jakeson21/8-Band-EQ/2-Band-EQ-Board/2-Band-EQ-Board.png

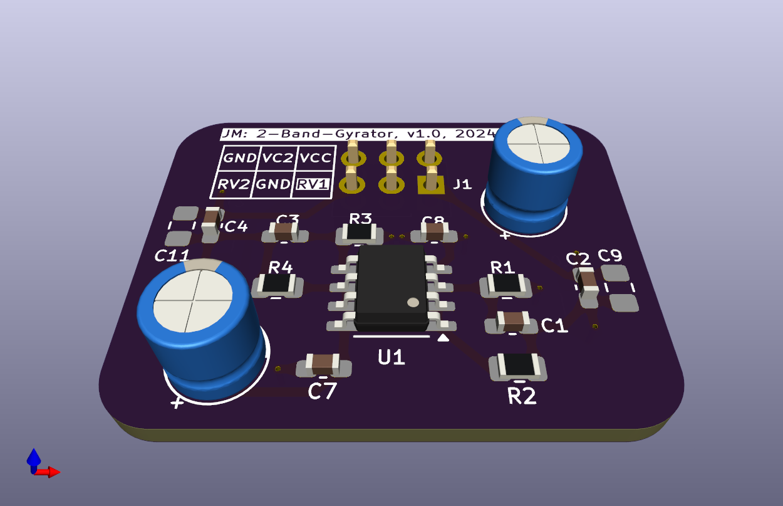
2-Band-EQ-Board/2-Band-EQ-Board.png
