jakeson21/8-Band-EQ/3d-models/RD901F-40-15R1.png

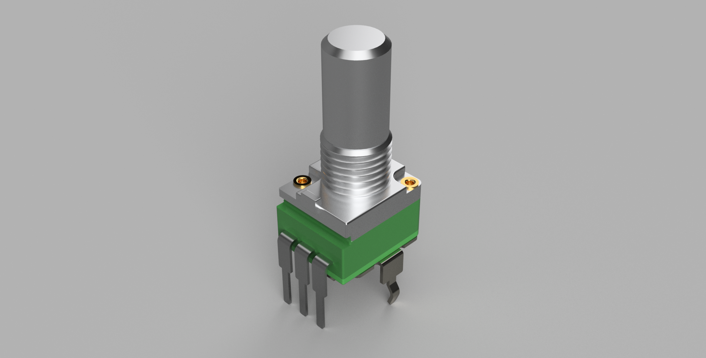
3d-models/RD901F-40-15R1.png
