jakeson21/8-Band-EQ/3d-models/RV16AF-41.png

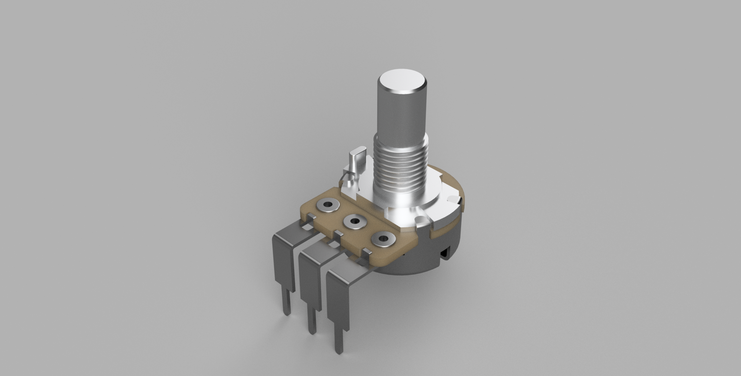
3d-models/RV16AF-41.png
