jakeson21/8-Band-EQ/Combined-BOM.xlsx

Sheet: Main-Board-BOM
Reference | Value | Datasheet | Footprint | Qty | DNP
C1,C17 | 10u | https://www.digikey.com/en/products/detail/w%C3%BCrth-elektronik/865080440002/5728025 | Capacitor_SMD:CP_Elec_4x5.4 | 2
C2 | 0.22u | https://www.digikey.com/en/products/detail/murata-electronics/GCM188R71E224KA55D/1765183 | Capacitor_SMD:C_0603_1608Metric_Pad1.08x0.95mm_HandSolder | 1
C3 | 270p | https://www.digikey.com/en/products/detail/yageo/CC0603KRX7R9BB271/372858 | Capacitor_SMD:C_0603_1608Metric_Pad1.08x0.95mm_HandSolder | 1
C4,C5,C18,C20,C21 | 100u | https://www.digikey.com/en/products/detail/kemet/ESK107M016AC3AA/3083016 | Capacitor_THT:CP_Radial_D5.0mm_P2.00mm | 5
C6,C7,C22,C23 | 0.1u | https://www.digikey.com/en/products/detail/yageo/CC0603KRX7R8BB104/2103079 | Capacitor_SMD:C_0603_1608Metric_Pad1.08x0.95mm_HandSolder | 4
C8,C9 | 1u | https://www.digikey.com/en/products/detail/kemet/C0603C105K4RACTU/2199788 | Capacitor_SMD:C_0603_1608Metric_Pad1.08x0.95mm_HandSolder | 2
C10 | 1n | https://www.digikey.com/en/products/detail/kemet/C0603C102K4RACTU/2199721 | Capacitor_SMD:C_0805_2012Metric | 1
C11,C16 | 22n | https://www.digikey.com/en/products/detail/kemet/C0603C223K4RAC7867/411092 | Capacitor_SMD:C_0805_2012Metric | 2
C12,C15 | 470p | https://www.digikey.com/en/products/detail/kemet/C0603C471K3RAC7867/2200814 | Capacitor_SMD:C_0805_2012Metric | 2
C13,C14 | 220p | https://www.digikey.com/en/products/detail/kemet/C0603C221K3RAC7867/2200227 | Capacitor_SMD:C_0805_2012Metric | 2
C19 | 47u | https://www.digikey.com/en/products/detail/w%C3%BCrth-elektronik/860020372004/5727028 | Capacitor_THT:CP_Radial_D5.0mm_P2.00mm | 1
C24 | 100u | https://www.digikey.com/en/products/detail/kemet/T491D107K016AT/818630 | Capacitor_Tantalum_SMD:CP_EIA-7343-31_Kemet-D_Pad2.25x2.55mm_HandSolder | 1 | DNP
D1,D2 | 1N914 | http://www.vishay.com/docs/85622/1n914.pdf | Diode_THT:D_DO-35_SOD27_P2.54mm_Vertical_AnodeUp | 2
D3 | 5.6V ZENER EDZVT2R5.6B | https://www.rohm.com/datasheet?p=EDZV5.6B&dist=Digi-key&media=referral&campaign=Digi-key | Diode_SMD:D_SOD-523 | 1
D4 | 1.5-2V | ~ | LED_THT:LED_D3.0mm_Clear | 1
D5 | 1N4001 | http://www.vishay.com/docs/88503/1n4001.pdf | Diode_THT:D_DO-41_SOD81_P7.62mm_Horizontal | 1
J1,J8 | B3B-XH-A | https://www.digikey.com/en/products/detail/jst-sales-america-inc/b3b-xh-a/1651046 | Connector_JST:JST_XH_B3B-XH-A_1x03_P2.50mm_Vertical | 2
J2,J3 | A-6730 | https://www.taydaelectronics.com/datasheets/files/A-6728.pdf | Project_Library:Jack_6.35mm_Neutrik_NMJ4HFD2_Horizontal | 2
J4 | A-4118 | http://www.taydaelectronics.com/datasheets/files/A-4118.pdf | Connector_BarrelJack:BarrelJack_Horizontal | 1
J5 | Gain | ~ | Connector_PinHeader_2.54mm:PinHeader_1x03_P2.54mm_Vertical | 1
POT1 | A-4728 | https://www.taydaelectronics.com/potentiometer-variable-resistors/rotary-potentiometer/linear/10k-ohm-linear-taper-potentiometer-knurled-plastic-round-shaft-p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 | Project_Library:Potentiometer_Alpha_RD901F-40-00D_Single_Vertical_CircularHoles | 1
Q1,Q3 | MMBF4393LT1G | https://www.digikey.com/en/products/detail/onsemi/MMBF4393LT1G/919583 | Package_TO_SOT_SMD:SOT-23-3 | 2
Q2,Q4 | 2N4401D75ZCT-ND | https://www.digikey.com/en/products/detail/onsemi/2n4401tar/458821 | Package_TO_SOT_THT:TO-92_Inline_Wide | 2
R1,R4,R5,R8 | 10K | ~ | Resistor_SMD:R_0805_2012Metric | 4
R2,R24 | 2.2K | ~ | Resistor_SMD:R_0805_2012Metric | 2
R3 | 470K | ~ | Resistor_SMD:R_0805_2012Metric | 1
R6,R7 | 3.3K | ~ | Resistor_SMD:R_0805_2012Metric | 2
R9,R11,R12,R13,R17,R21,R23 | 1M | ~ | Resistor_SMD:R_0805_2012Metric | 7
R10 | 100 | ~ | Resistor_SMD:R_0805_2012Metric | 1
R14,R15,R16,R18,R19,R20 | 56K | ~ | Resistor_SMD:R_0805_2012Metric | 6
R22 | 4.7K | ~ | Resistor_SMD:R_0805_2012Metric | 1
SW1 | SW_Push | ~ | Connector_Molex:Molex_KK-254_AE-6410-02A_1x02_P2.54mm_Vertical | 1
U1,U2 | TL072 | http://www.ti.com/lit/ds/symlink/tl071.pdf | Package_SO:SOIC-8_3.9x4.9mm_P1.27mm | 2

Sheet: 4-Row-POT-BOM
Reference | Value | Datasheet | Footprint | Qty | DNP
J1,J2 | FHMD-DA006G1NBON-B | 4324-FHMD-DA006G1NBON-B-ND | Connector_PinSocket_2.54mm:PinSocket_2x03_P2.54mm_Vertical | 2
J3,J4,J5,J6 | S3B-XH-A | 455-S3B-XH-A-ND | Connector_JST:JST_XH_S3B-XH-A_1x03_P2.50mm_Horizontal | 4
RV1,RV2,RV3,RV4 | 10K | https://www.taydaelectronics.com/potentiometer-variable-resistors/rotary-potentiometer/linear/10k-ohm-linear-taper-potentiometer-knurled-plastic-round-shaft-p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 | Project_Library:Potentiometer_Alpha_RD901F-40-00D_Single_Vertical_CircularHoles | 4

Sheet: 2-Band-BOM
Reference | Value | Datasheet | Footprint | Qty | DNP
C1 | 33n |  | Capacitor_SMD:C_0603_1608Metric_Pad1.08x0.95mm_HandSolder | 1
C2 | 0.68u |  | Capacitor_SMD:C_0603_1608Metric_Pad1.08x0.95mm_HandSolder | 1
C3 | 15n |  | Capacitor_SMD:C_0603_1608Metric_Pad1.08x0.95mm_HandSolder | 1
C4 | 0.33u |  | Capacitor_SMD:C_0603_1608Metric_Pad1.08x0.95mm_HandSolder | 1
C5,C6 | 100u | https://www.digikey.com/en/products/detail/kemet/ESK107M016AC3AA/3083016 | Capacitor_THT:CP_Radial_D5.0mm_P2.00mm | 2
C7,C8 | 0.1u | https://www.digikey.com/en/products/detail/yageo/CC0603KRX7R8BB104/2103079 | Capacitor_SMD:C_0603_1608Metric_Pad1.08x0.95mm_HandSolder | 2
C9,C11 | 1.5u |  | Capacitor_SMD:C_0805_2012Metric_Pad1.18x1.45mm_HandSolder | 2 | DNP
C10,C12 | 3.3u |  | Capacitor_SMD:C_1206_3216Metric_Pad1.33x1.80mm_HandSolder | 2 | DNP
J1 | PHED-DS006G1ABOGA-A006 | https://www.digikey.com/en/products/detail/superior-tech/PHED-DS006G1ABOGA-A006/16583466 | Connector_PinHeader_2.54mm:PinHeader_2x03_P2.54mm_Vertical | 1
R1,R3 | 100K | ~ | Resistor_SMD:R_0805_2012Metric | 2
R2,R4 | 330 | ~ | Resistor_SMD:R_0805_2012Metric | 2
U1 | 296-TL072HIDRCT-ND | http://www.ti.com/lit/ds/symlink/tl071.pdf | Package_SO:SOIC-8_3.9x4.9mm_P1.27mm | 1

Sheet: Sheet1
On Hand | Order | Reference | Value | Datasheet | Footprint | Qty | DNP
 | 10 | C1 | 33n | https://www.digikey.com/en/products/detail/yageo/CC0603JRX7R9BB333/5883689 | Capacitor_SMD:C_0603_1608Metric_Pad1.08x0.95mm_HandSolder | 1
 | 10 | C1,C17 | 10u | https://www.digikey.com/en/products/detail/w%C3%BCrth-elektronik/865080440002/5728025 | Capacitor_SMD:CP_Elec_4x5.4 | 2
 | 10 | C10 | 1n | https://www.digikey.com/en/products/detail/kemet/C0603C102K4RACTU/2199721 | Capacitor_SMD:C_0805_2012Metric | 1
 | 10 | C10,C12 | 3.3u | https://www.digikey.com/en/products/detail/samsung-electro-mechanics/CL31B335KAHVPNE/5961344 | Capacitor_SMD:C_1206_3216Metric_Pad1.33x1.80mm_HandSolder | 2 | DNP
 | 10 | C11,C16 | 22n | https://www.digikey.com/en/products/detail/kemet/C0603C223K4RAC7867/411092 | Capacitor_SMD:C_0805_2012Metric | 2
 | 10 | C12,C15 | 470p | https://www.digikey.com/en/products/detail/kemet/C0603C471K3RAC7867/2200814 | Capacitor_SMD:C_0805_2012Metric | 2
 | 10 | C13,C14 | 220p | https://www.digikey.com/en/products/detail/kemet/C0603C221K3RAC7867/2200227 | Capacitor_SMD:C_0805_2012Metric | 2
8 | 0 | C19 | 47u | https://www.digikey.com/en/products/detail/w%C3%BCrth-elektronik/860020372004/5727028 | Capacitor_THT:CP_Radial_D5.0mm_P2.00mm | 1
 | 10 | C2 | 0.22u | https://www.digikey.com/en/products/detail/murata-electronics/GCM188R71E224KA55D/1765183 | Capacitor_SMD:C_0603_1608Metric_Pad1.08x0.95mm_HandSolder | 1
 | 10 | C2 | 0.68u | https://www.digikey.com/en/products/detail/yageo/CC0603KRX7R8BB684/16797741 | Capacitor_SMD:C_0603_1608Metric_Pad1.08x0.95mm_HandSolder | 1
0 | 0 | C24 | 100u | https://www.digikey.com/en/products/detail/kemet/T491D107K016AT/818630 | Capacitor_Tantalum_SMD:CP_EIA-7343-31_Kemet-D_Pad2.25x2.55mm_HandSolder | 1 | DNP
 | 10 | C3 | 270p | https://www.digikey.com/en/products/detail/yageo/CC0603KRX7R9BB271/372858 | Capacitor_SMD:C_0603_1608Metric_Pad1.08x0.95mm_HandSolder | 1
 | 10 | C3 | 15n | https://www.digikey.com/en/products/detail/yageo/CC0603JRX7R9BB153/5883678 | Capacitor_SMD:C_0603_1608Metric_Pad1.08x0.95mm_HandSolder | 1
 | 10 | C4 | 330n | https://www.digikey.com/en/products/detail/samsung-electro-mechanics/CL31B335KAHVPNE/5961344 | Capacitor_SMD:C_0603_1608Metric_Pad1.08x0.95mm_HandSolder | 1
8 | 10 | C4,C5,C18,C20,C21 | 100u | https://www.digikey.com/en/products/detail/kemet/ESK107M016AC3AA/3083016 | Capacitor_THT:CP_Radial_D5.0mm_P2.00mm | 5
 | 0 | C5,C6 | 100u | https://www.digikey.com/en/products/detail/kemet/ESK107M016AC3AA/3083016 | Capacitor_THT:CP_Radial_D5.0mm_P2.00mm | 2
 | 20 | C6,C7,C22,C23 | 0.1u | https://www.digikey.com/en/products/detail/yageo/CC0603KRX7R8BB104/2103079 | Capacitor_SMD:C_0603_1608Metric_Pad1.08x0.95mm_HandSolder | 4
 | 0 | C7,C8 | 0.1u | https://www.digikey.com/en/products/detail/yageo/CC0603KRX7R8BB104/2103079 | Capacitor_SMD:C_0603_1608Metric_Pad1.08x0.95mm_HandSolder | 2
 | 20 | C8,C9 | 1u | https://www.digikey.com/en/products/detail/kemet/C0603C105K4RACTU/2199788 | Capacitor_SMD:C_0603_1608Metric_Pad1.08x0.95mm_HandSolder | 2
 | 10 | C9,C11 | 1.5u | https://www.digikey.com/en/products/detail/tdk-corporation/CGA4J3X7R1E155K125AB/3949992 | Capacitor_SMD:C_0805_2012Metric_Pad1.18x1.45mm_HandSolder | 2 | DNP
 | 10 | D1,D2 | 1N914 | https://www.digikey.com/en/products/detail/onsemi/1N914/978749 | Diode_THT:D_DO-35_SOD27_P2.54mm_Vertical_AnodeUp | 2
 | 10 | D3 | 5.6V ZENER EDZVT2R5.6B | https://www.rohm.com/datasheet?p=EDZV5.6B&dist=Digi-key&media=referral&campaign=Digi-key | Diode_SMD:D_SOD-523 | 1
10 | 0 | D4 | 1.5-2V | ~ | LED_THT:LED_D3.0mm_Clear | 1
10 | 0 | D5 | 1N4001 | http://www.vishay.com/docs/88503/1n4001.pdf | Diode_THT:D_DO-41_SOD81_P7.62mm_Horizontal | 1
 | 10 | J1 | PHED-DS006G1ABOGA-A006 | https://www.digikey.com/en/products/detail/superior-tech/PHED-DS006G1ABOGA-A006/16583466 | Connector_PinHeader_2.54mm:PinHeader_2x03_P2.54mm_Vertical | 1
 | 10 | J1,J2 | FHMD-DA006G1NBON-B | 4324-FHMD-DA006G1NBON-B-ND | Connector_PinSocket_2.54mm:PinSocket_2x03_P2.54mm_Vertical | 2
 | 10 | J1,J8 | B3B-XH-A | https://www.digikey.com/en/products/detail/jst-sales-america-inc/b3b-xh-a/1651046 | Connector_JST:JST_XH_B3B-XH-A_1x03_P2.50mm_Vertical | 2
NEED 4 | 0 | J2,J3 | A-6730 | https://www.taydaelectronics.com/datasheets/files/A-6728.pdf | Project_Library:Jack_6.35mm_Neutrik_NMJ4HFD2_Horizontal | 2
 | 10 | J3,J4,J5,J6 | S3B-XH-A | 455-S3B-XH-A-ND | Connector_JST:JST_XH_S3B-XH-A_1x03_P2.50mm_Horizontal | 4
1 | 0 | J4 | A-4118 | http://www.taydaelectronics.com/datasheets/files/A-4118.pdf | Connector_BarrelJack:BarrelJack_Horizontal | 1
100 | 0 | J5 | Gain | ~ | Connector_PinHeader_2.54mm:PinHeader_1x03_P2.54mm_Vertical | 1
NEED 10+ | 0 | POT1 | A-4728 | https://www.taydaelectronics.com/potentiometer-variable-resistors/rotary-potentiometer/linear/10k-ohm-linear-taper-potentiometer-knurled-plastic-round-shaft-p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 | Project_Library:Potentiometer_Alpha_RD901F-40-00D_Single_Vertical_CircularHoles | 1
 | 10 | Q1,Q3 | MMBF4393LT1G | https://www.digikey.com/en/products/detail/onsemi/MMBF4393LT1G/919583 | Package_TO_SOT_SMD:SOT-23-3 | 2
20 | 0 | Q2,Q4 | 2N4401D75ZCT-ND | https://www.digikey.com/en/products/detail/onsemi/2n4401tar/458821 | Package_TO_SOT_THT:TO-92_Inline_Wide | 2
50 | 0 | R1,R3 | 100K | ~ | Resistor_SMD:R_0805_2012Metric | 2
50 | 0 | R1,R4,R5,R8 | 10K | ~ | Resistor_SMD:R_0805_2012Metric | 4
50 | 0 | R10 | 100 | ~ | Resistor_SMD:R_0805_2012Metric | 1
50 | 0 | R14,R15,R16,R18,R19,R20 | 56K | ~ | Resistor_SMD:R_0805_2012Metric | 6
50 | 0 | R2,R24 | 2.2K | ~ | Resistor_SMD:R_0805_2012Metric | 2
50 | 0 | R2,R4 | 330 | ~ | Resistor_SMD:R_0805_2012Metric | 2
50 | 0 | R22 | 4.7K | ~ | Resistor_SMD:R_0805_2012Metric | 1
50 | 0 | R3 | 470K | ~ | Resistor_SMD:R_0805_2012Metric | 1
50 | 0 | R6,R7 | 3.3K | ~ | Resistor_SMD:R_0805_2012Metric | 2
50 | 0 | R9,R11,R12,R13,R17,R21,R23 | 1M | ~ | Resistor_SMD:R_0805_2012Metric | 7
NEED above | 0 | RV1,RV2,RV3,RV4 | 10K | https://www.taydaelectronics.com/potentiometer-variable-resistors/rotary-potentiometer/linear/10k-ohm-linear-taper-potentiometer-knurled-plastic-round-shaft-p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 | Project_Library:Potentiometer_Alpha_RD901F-40-00D_Single_Vertical_CircularHoles | 4
4 | 0 | SW1 | SW_Push | ~ | Connector_Molex:Molex_KK-254_AE-6410-02A_1x02_P2.54mm_Vertical | 1
 | 0 | U1 | 296-TL072HIDRCT-ND | http://www.ti.com/lit/ds/symlink/tl071.pdf | Package_SO:SOIC-8_3.9x4.9mm_P1.27mm | 1
 | 20 | U1,U2 | 296-TL072HIDRCT-ND | http://www.ti.com/lit/ds/symlink/tl071.pdf | Package_SO:SOIC-8_3.9x4.9mm_P1.27mm | 2
 | 11.74
 | 0.7
 | 2.43
 | $14.87
