jakeson21/8-Band-EQ/Cap_options.xlsx

Sheet: Options
C | URL | Spacing | Size | Description
1.5u | https://www.digikey.com/en/products/detail/kemet/R82DC4150AA60J/2704685 | 0.197" (5.00mm) | 0.283" L x 0.236" W (7.20mm x 6.00mm) | CAP FILM 1.5UF 5% 63VDC RADIAL | $0.81 | $0.70 | https://www.taydaelectronics.com/capacitors/polyester-film-box-type-capacitors/1-5uf-1500nf-63v-5-polyester-film-box-type-capacitor.html
3.3u | https://www.digikey.com/en/products/detail/kemet/R60DF4330AA6AK/6124494 | 0.394" (10.00mm) | 0.512" L x 0.236" W (13.00mm x 6.00mm) | CAP FILM 3.3UF 10% 63VDC RADIAL | $1.28
0.33u | https://www.digikey.com/en/products/detail/murata-electronics/GRM31C5C1E334JE01L/16033803 |  | 1206 (3216 Metric) | CAP CER 0.33UF 25V C0G/NP0 1206

Sheet: Sheet1
Relative Permittivity of Common Dielectric Materials
Material | εr(k)
Vacuum | 1 |  | Size | Cost | Min C | Max C | εr(k) | C vs. T | ESR | Service Life | DC Bias | Acoustic Noise
Polyethylene sulfide | 3 | MLCC | 1 | 1 |  |  | 5 | 5 | 5
Polyethylene terephthalate | 3.3
Polypropylene | 2.2
Impregnated paper | 2 to 6
Mylar | 3.1
Mica | 6.8
Aluminum oxide | 8.5
Tantalum pentoxide | 27.7
Paraelectric ceramics (Class I) | 5 to 90
Strontium titanate | 310
Barium titanate (Class II) | 3000 to 8000
