jakeson21/8-Band-EQ/3d-models/NMJ4HFD2.STEP

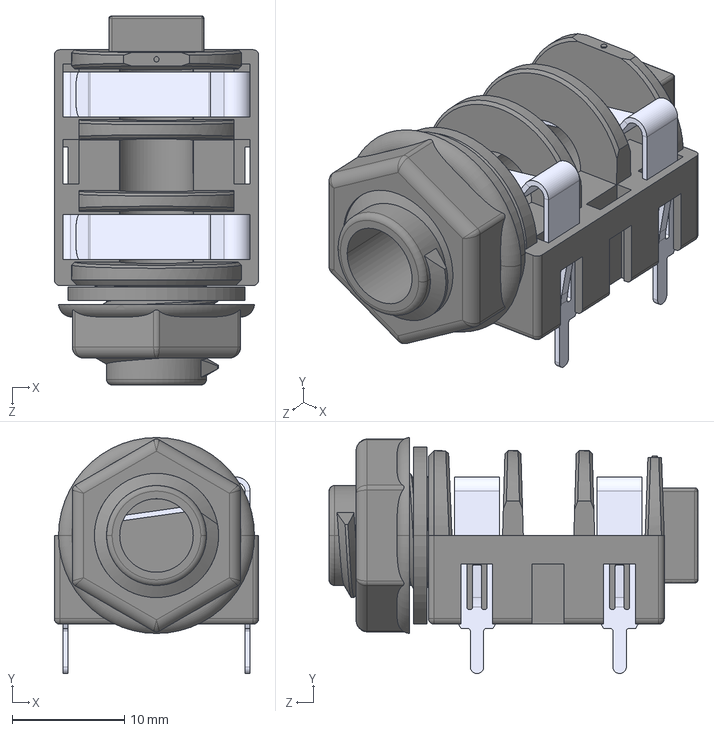
[picture p4: CAD file, 2024-11-23]
3d-models/NMJ4HFD2.STEP
18.2 x 21.0 x 32.9 mm
