jakeson21/8-Band-EQ/Drill_sheet.dxf

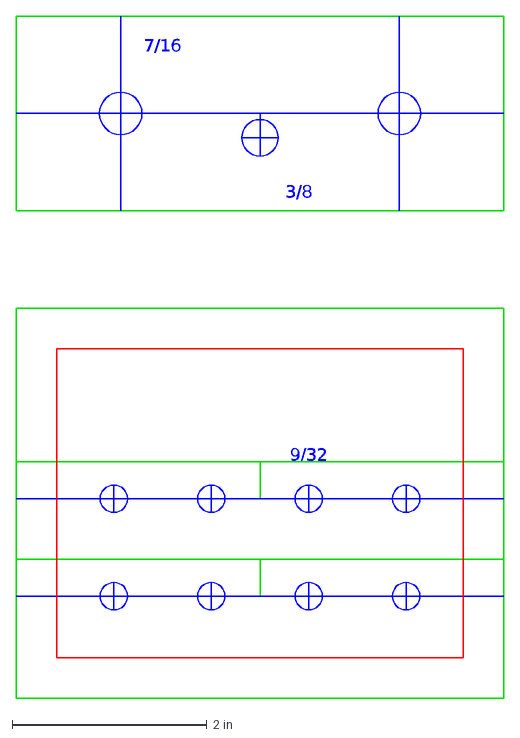
[picture p5: CAD file, 2025-08-23]
Drill_sheet.dxf
7/16
3/8
9/32
