jakeson21/8-Band-EQ/3d-models/M 3528-15.step

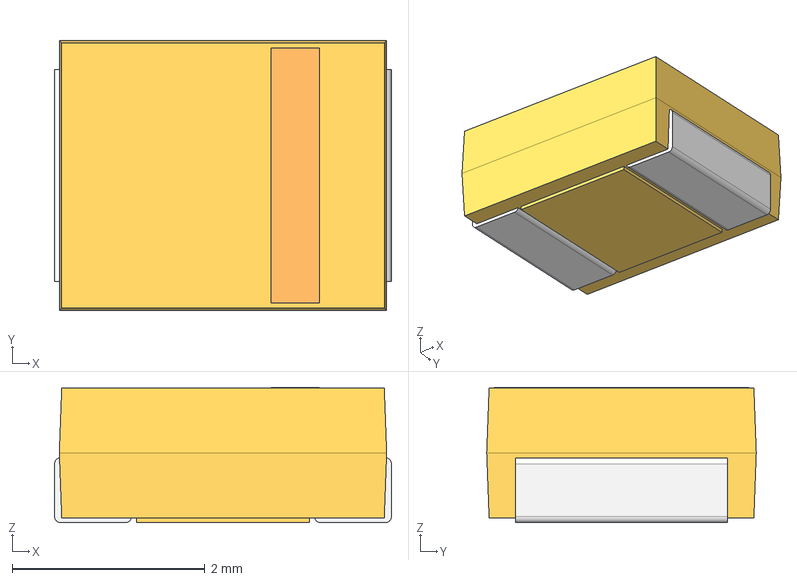
[picture p6: CAD file, 2024-11-23]
3d-models/M 3528-15.step
3.50 x 2.80 x 1.41 mm
