jakeson21/8-Band-EQ/3d-models/NMJ4HCD2.step

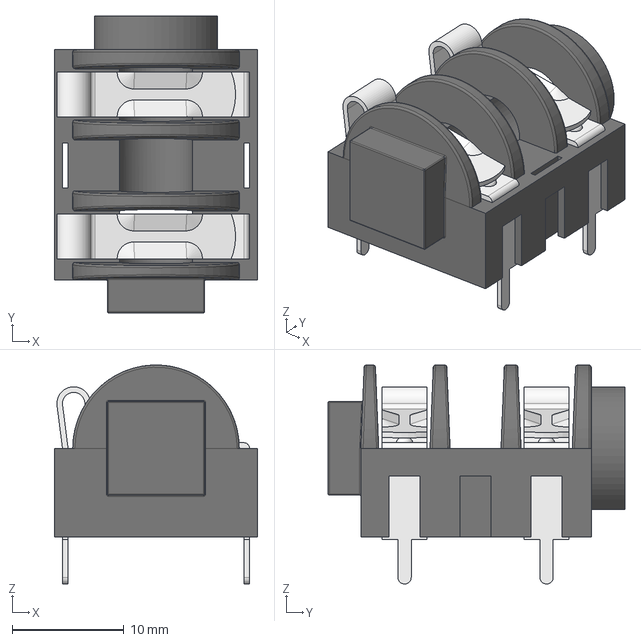
[picture p7: CAD file, 2024-11-23]
3d-models/NMJ4HCD2.step
18.2 x 26.5 x 19.6 mm
