jakeson21/8-Band-EQ/3d-models/C 6032-28.step

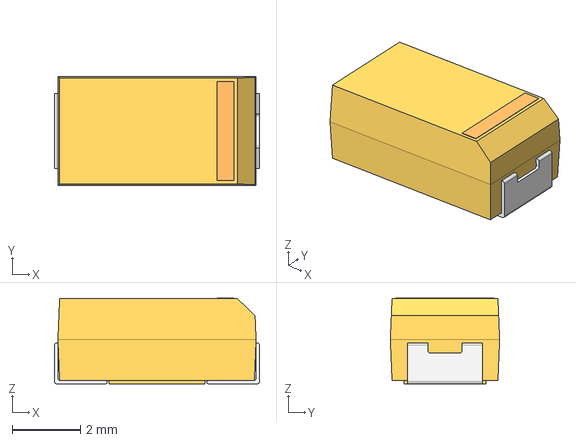
[picture p8: CAD file, 2024-11-23]
3d-models/C 6032-28.step
6.00 x 3.20 x 2.51 mm
