jakeson21/8-Band-EQ/3d-models/D 7343-31.step

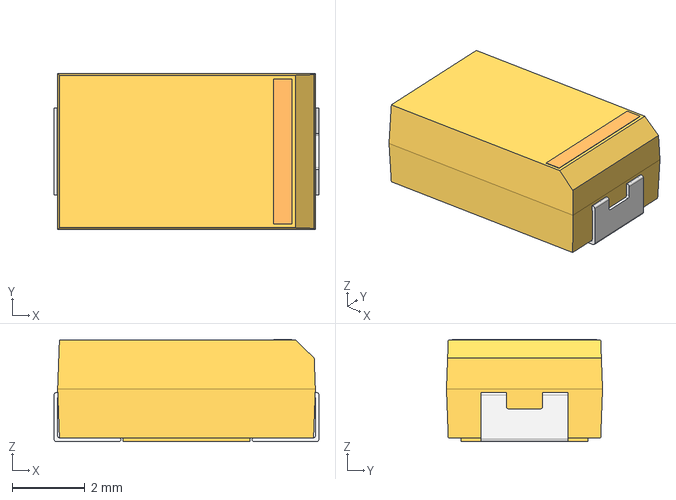
[picture p9: CAD file, 2024-11-23]
3d-models/D 7343-31.step
7.30 x 4.30 x 2.81 mm
