jakeson21/8-Band-EQ/3d-models/S 3216-12.step

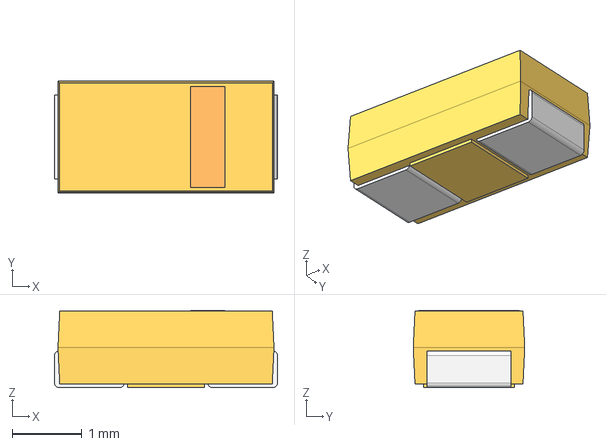
[picture p10: CAD file, 2024-11-23]
3d-models/S 3216-12.step
3.20 x 1.60 x 1.11 mm
