jakeson21/8-Band-EQ/3d-models/RD901F-40-15R1.step

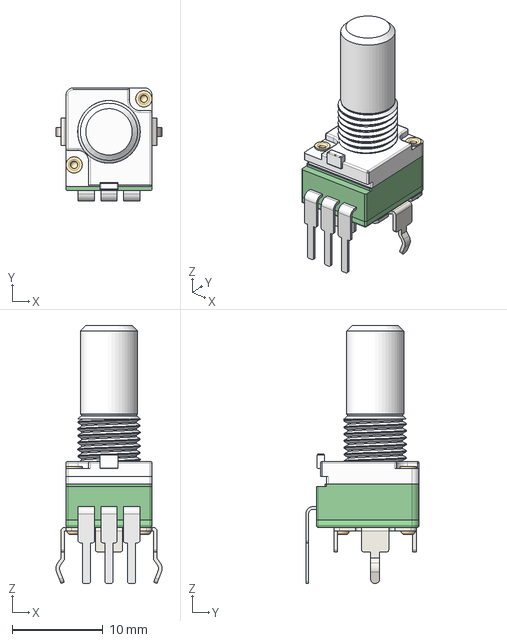
[picture p11: CAD file, 2024-11-23]
3d-models/RD901F-40-15R1.step
11.7 x 12.5 x 28.5 mm
