jakeson21/8-Band-EQ/3d-models/RV16AF-41.step

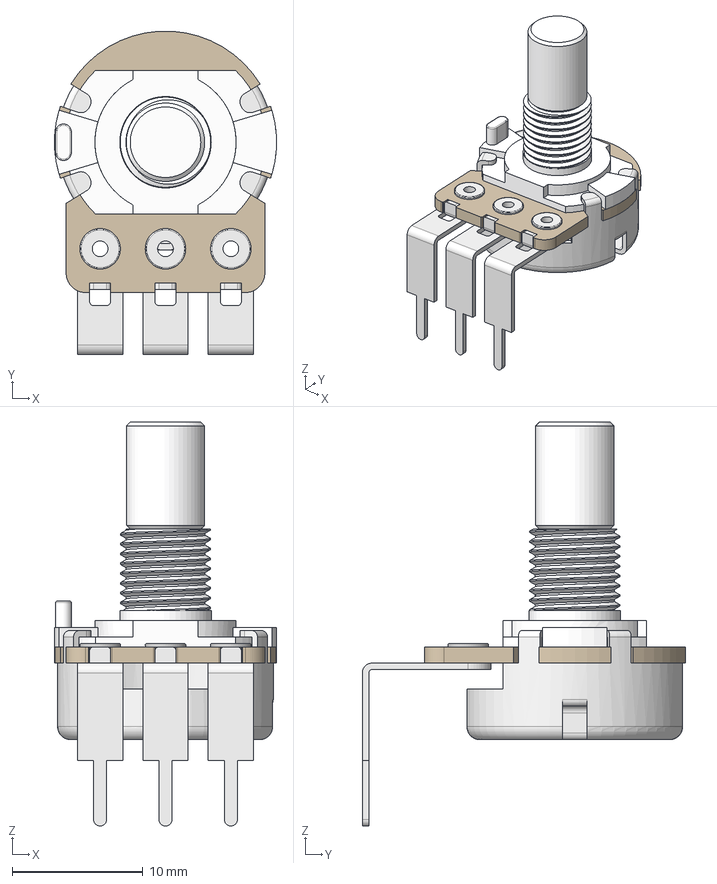
[picture p12: CAD file, 2024-11-23]
3d-models/RV16AF-41.step
17.0 x 24.7 x 30.9 mm
