jakeson21/8-Band-EQ/3d-models/1444-542.stp

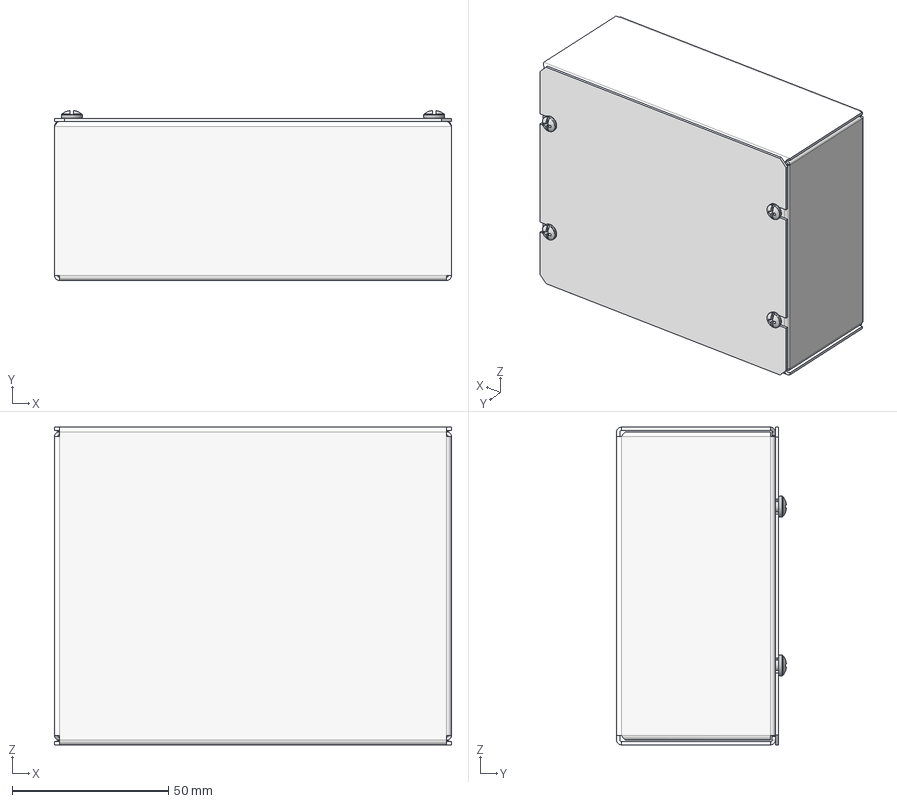
[picture p13: CAD file, 2024-11-23]
3d-models/1444-542.stp
127.0 x 54.3 x 101.6 mm
6-32 (SC18394) x 4
