jakeson21/8-Band-EQ/3d-models/V 7343-20.step

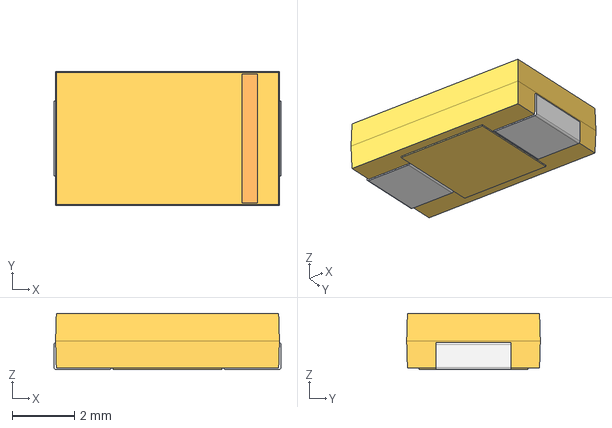
[picture p14: CAD file, 2024-11-23]
3d-models/V 7343-20.step
7.30 x 4.30 x 1.81 mm
