jakeson21/8-Band-EQ/3d-models/X 7343-43.step

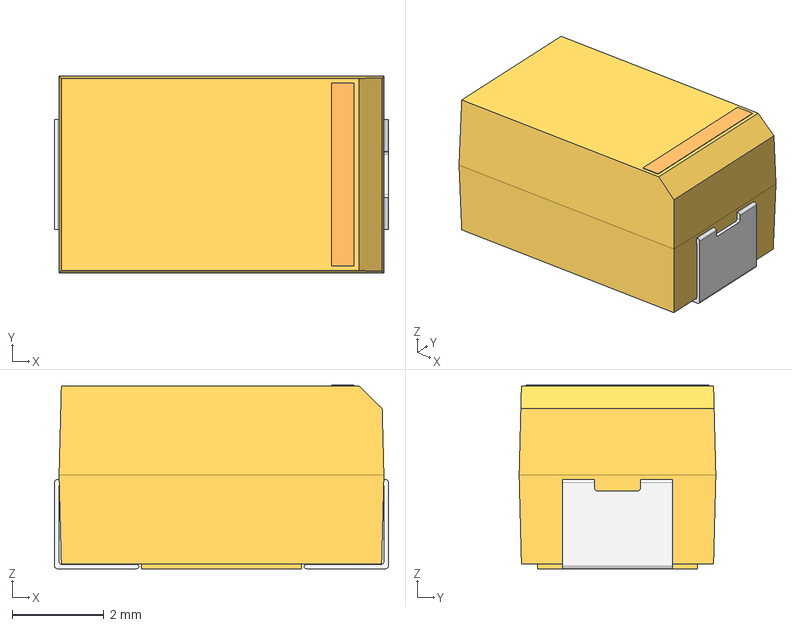
[picture p15: CAD file, 2024-11-23]
3d-models/X 7343-43.step
7.30 x 4.30 x 4.01 mm
