jakeson21/8-Band-EQ/3d-models/T 3528-12.step

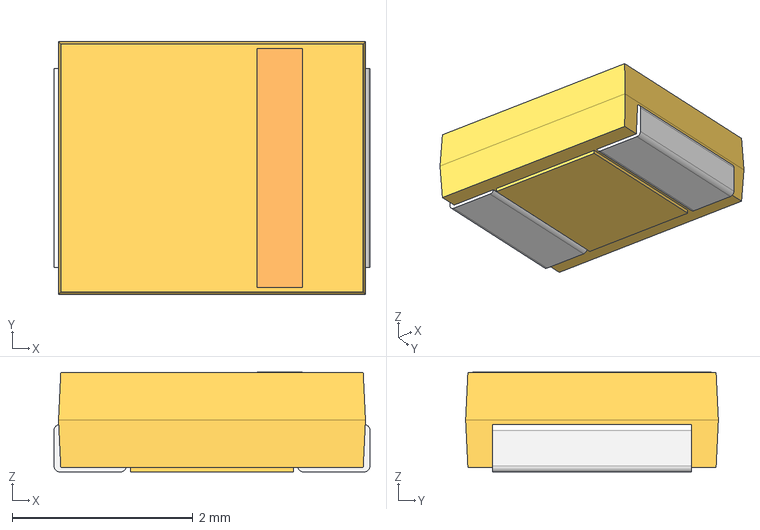
[picture p16: CAD file, 2024-11-23]
3d-models/T 3528-12.step
3.50 x 2.80 x 1.11 mm
