jakeson21/8-Band-EQ/3d-models/A 3216-18.step

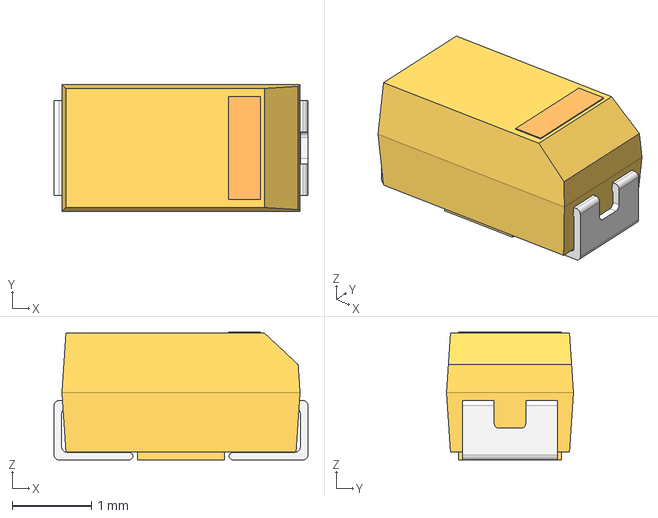
[picture p17: CAD file, 2024-11-23]
3d-models/A 3216-18.step
3.20 x 1.60 x 1.61 mm
