jakeson21/8-Band-EQ/3d-models/B 3528-21.step

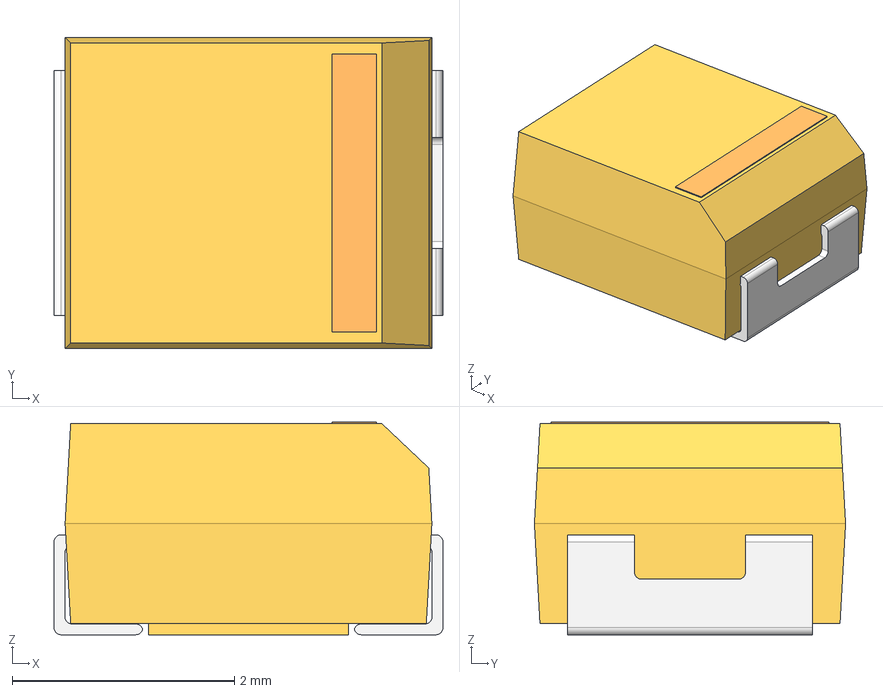
[picture p18: CAD file, 2024-11-23]
3d-models/B 3528-21.step
3.50 x 2.80 x 1.91 mm
