jakeson21/8-Band-EQ/3d-models/P 2012-15.step

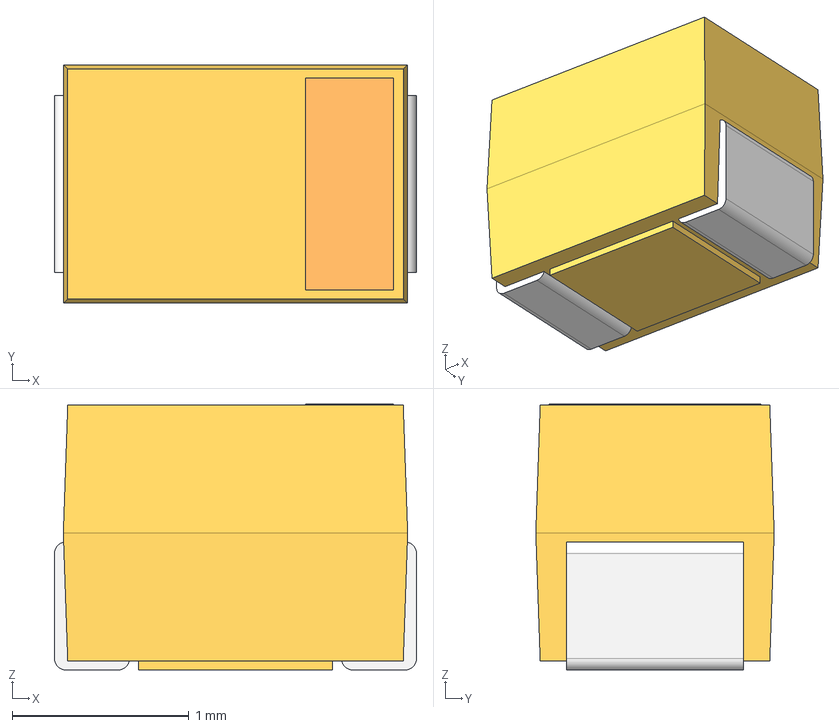
[picture p19: CAD file, 2024-11-23]
3d-models/P 2012-15.step
2.05 x 1.35 x 1.51 mm
