jakeson21/8-Band-EQ/3d-models/U 6032-15.step

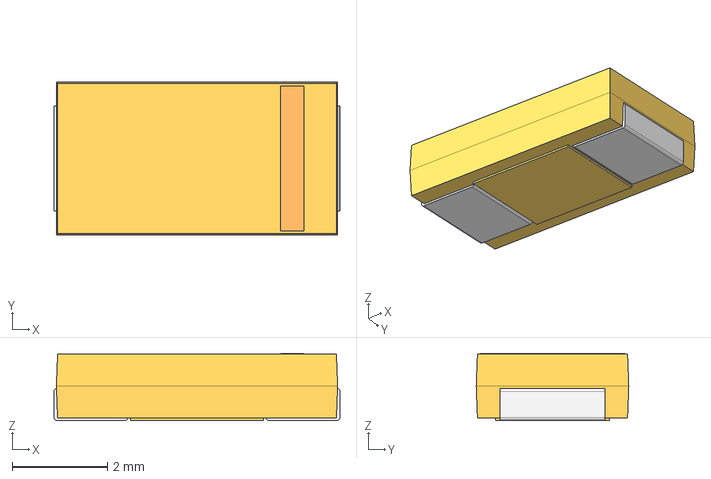
[picture p20: CAD file, 2024-11-23]
3d-models/U 6032-15.step
6.00 x 3.20 x 1.41 mm
