jakeson21/8-Band-EQ/3d-models/W 7343-15.step

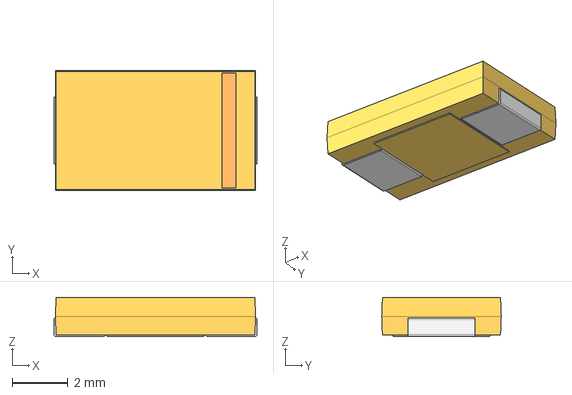
[picture p21: CAD file, 2024-11-23]
3d-models/W 7343-15.step
7.30 x 4.30 x 1.41 mm
