jakeson21/8-Band-EQ/3d-models/R 2012-12.step

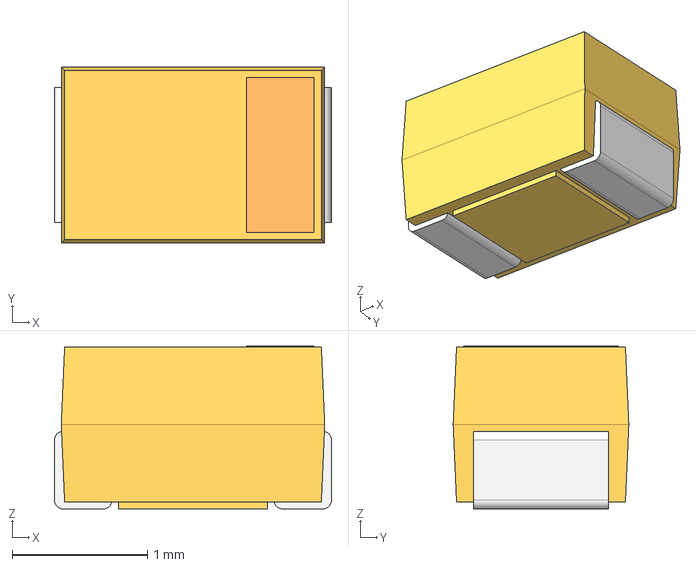
[picture p22: CAD file, 2024-11-23]
3d-models/R 2012-12.step
2.05 x 1.30 x 1.21 mm
