jakeson21/8-Band-EQ/3d-models/E 7360-38.step

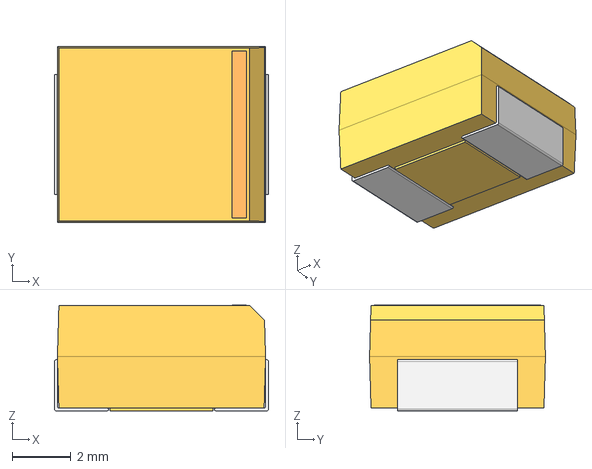
[picture p23: CAD file, 2024-11-23]
3d-models/E 7360-38.step
7.30 x 6.00 x 3.61 mm
