jakeson21/8-Band-EQ/(list of files, cad)

Other CAD files:
3d-models/1444-542.igs
3d-models/A 3216-18.iges
3d-models/B 3528-21.iges
3d-models/C 6032-28.iges
3d-models/D 7343-31.iges
3d-models/E 7360-38.iges
3d-models/M 3528-15.iges
3d-models/NMJ nut washer.step
3d-models/NMJ nut.step
3d-models/NMJ washer.step
3d-models/P 2012-15.iges
3d-models/R 2012-12.iges
3d-models/RD901F-40-15R1.f3d
3d-models/RV16AF-41.f3d
3d-models/S 3216-12.iges
3d-models/T 3528-12.iges
3d-models/U 6032-15.iges
3d-models/V 7343-20.iges
3d-models/W 7343-15.iges
3d-models/X 7343-43.iges
