jakeson21/8-Band-EQ/spice/EQ8.asc

A1: modulate; mark=10 space=0 Rout=10K
C1: cap; 0.056µ; V=16 Irms=0 Rser=0 Lser=0 mfg="Murata" pn="GCM155R71C563KA55" type="X7R"
C2: cap; 1.5µ; V=16 Irms=0 Rser=0.0097 Lser=659p mfg="Würth Elektronik" pn="885012108013 WCAP-CSGP 1206" type="X5R"
C3: cap; 0.033µ; V=16 Irms=0 Rser=0.0546 Lser=715p mfg="Würth Elektronik" pn="885012208028 WCAP-CSGP 1206" type="X7R"
C4: cap; 0.68µ; V=16 Irms=4.35 Rser=0.0130017 Lser=0 mfg="KEMET" pn="C0805C684K4PAC" type="X5R"
C5: cap; 0.22µ; V=16 Irms=0 Rser=0.0511 Lser=447p mfg="Würth Elektronik" pn="885012208029 WCAP-CSGP 1206" type="X7R"
C6: cap; 0.015µ; V=16 Irms=0 Rser=0 Lser=0 mfg="Murata" pn="GCM155R71C563KA55" type="X7R"
C7: cap; 0.33µ; V=16 Irms=0 Rser=0.0122 Lser=360p mfg="Würth Elektronik" pn="885012207048 WCAP-CSGP 0805" type="X7R"
C8: cap; 0.0082µ; V=16 Irms=0 Rser=0 Lser=0 mfg="Murata" pn="GCM155R71C563KA55" type="X7R"
C9: cap; 0.15µ; V=16 Irms=0 Rser=0.0192 Lser=477p mfg="Würth Elektronik" pn="885012206047 WCAP-CSGP 0603" type="X7R"
C10: cap; 0.0039µ; V=16 Irms=0 Rser=0 Lser=0 mfg="Murata" pn="GCM155R71C563KA55" type="X7R"
C11: cap; 0.1µ; V=16 Irms=0 Rser=0.0236 Lser=666p mfg="Würth Elektronik" pn="885012208030 WCAP-CSGP 1206" type="X7R"
C12: cap; 0.0022µ; V=16 Irms=0 Rser=0 Lser=0 mfg="Murata" pn="GCM155R71C563KA55" type="X7R"
C13: cap; 0.039µ; V=16 Irms=442m Rser=0.296183 Lser=0 mfg="KEMET" pn="C0603C393K4RAC" type="X7R"
C14: cap; 270p; V=50 Irms=1.95623 Rser=0.0548754 Lser=299.014p mfg="Vishay" pn="VJ0603D271KXAAJ" type="COG"
C16: cap; 0.1µ; V=16 Irms=0 Rser=0 Lser=0 mfg="Murata" pn="GCM155R71C563KA55" type="X7R"
C17: polcap; 10µ; V=16 Irms=0 Rser=2.8 Lser=0 mfg="AVX" pn="TAJC106M016" type="Tantalum"
C18: cap; 3.3µ; V=16 Irms=10.3 Rser=0.0102642 Lser=0 mfg="KEMET" pn="C1210C335K4RAC" type="X7R"
C19: cap; 0.022µ; V=16 Irms=0 Rser=0.0511 Lser=447p mfg="Würth Elektronik" pn="885012208029 WCAP-CSGP 1206" type="X7R"
C20: cap; 0.022µ; V=16 Irms=0 Rser=0.0511 Lser=447p mfg="Würth Elektronik" pn="885012208029 WCAP-CSGP 1206" type="X7R"
C21: cap; 1µ; V=50 Irms=0 Rser=0.0115 Lser=800p mfg="Würth Elektronik" pn="885012206126 WCAP-CSGP 0603" type="X7R"
C22: cap; 0.0012µ; V=16 Irms=0 Rser=0 Lser=0 mfg="Murata" pn="GCM155R71C563KA55" type="X7R"
C23: cap; 0.022µ; V=16 Irms=0 Rser=0.0519 Lser=449p mfg="Würth Elektronik" pn="885012208027 WCAP-CSGP 1206" type="X7R"
C24: cap; 470p; V=16 Irms=0 Rser=0.34 Lser=421p mfg="Würth Elektronik" pn="885012208021 WCAP-CSGP 1206" type="X7R"
C25: cap; 220p; V=16 Irms=0 Rser=0.5734 Lser=186p mfg="Würth Elektronik" pn="885012205021 WCAP-CSGP 0402" type="X7R"
C26: cap; 470p; V=16 Irms=0 Rser=0.34 Lser=421p mfg="Würth Elektronik" pn="885012208021 WCAP-CSGP 1206" type="X7R"
C27: cap; 220p; V=16 Irms=0 Rser=0.5734 Lser=186p mfg="Würth Elektronik" pn="885012205021 WCAP-CSGP 0402" type="X7R"
C28: cap; 0.001µ; V=16 Irms=0 Rser=0.5734 Lser=186p
C29: polcap; 10µ; V=16 Irms=23m Rser=1.45 Lser=1.3p mfg="Würth Elektronik" pn="865090340002 WCAP-ASLU 4.3x4.3" type="Al electrolytic"
C30: cap; 1µ; V=50 Irms=0 Rser=0.0115 Lser=800p mfg="Würth Elektronik" pn="885012206126 WCAP-CSGP 0603" type="X7R"
D1: diode; 1N914
D2: diode; 1N914
D3: zener; STZ5_6N
D4: LED; LXHL-BW02
J1: njf; 2N3819
J2: njf; 2N3819
Q1: npn; 2N4401
Q2: npn; 2N4401
R1: res; 100K
R2: res; 330
R3: res; 1Meg
R4: res; 82K
R5: res; 330
R7: res; 10K
R8: res; 10K
R9: res; 2.2K
R10: res; 10K
R11: res; 10K
R12: res; 470K
R13: res; 100K
R14: res; 330
R16: res; 100K
R17: res; 330
R19: res; 82k
R20: res; 330
R22: res; 82k
R23: res; 330
R26: res; 100K
R27: res; 330
R29: res; 1Meg
R30: res; 1Meg
R31: res; 3.9K
R32: res; 1Meg
R33: res; 82k
R34: res; 330
R36: res; 1Meg
R37: res; 4.7K
R38: res; 100K
R39: res; 100K
R40: res; 56K
R41: res; 56K
R42: res; 56K
R43: res; 56K
R44: res; 1Meg
R45: res; 100
R46: res; 1Meg
S1: sw; FOOTSW
U1: TL07XH_TL08XH
U2: TL07XH_TL08XH
U3: pot; Rtot=10K wiper={P1}
U4: pot; Rtot=10K wiper={P2}
U5: TL07XH_TL08XH
U6: TL07XH_TL08XH
U7: TL07XH_TL08XH
U8: pot; Rtot=10K wiper={P3}
U9: TL07XH_TL08XH
U10: pot; Rtot=10K wiper={P4}
U11: TL07XH_TL08XH
U12: pot; Rtot=10K wiper={P5}
U13: TL07XH_TL08XH
U14: pot; Rtot=10K wiper={P6}
U15: TL07XH_TL08XH
U16: pot; Rtot=10K wiper={G}
U17: pot; Rtot=10K wiper={P0}
U19: OPA1692
U20: OPA1692
U22: pot; Rtot=10K wiper={P7}
U23: TL07XH_TL08XH
U24: TL07XH_TL08XH
V1: voltage; 4.5
V2: voltage; 4.5
V3: voltage; SINE(0 1 100); AC 1
V4: voltage; PWL(0 10 1 100)
V5: voltage; PWL(0 1 10 1)
VSW: voltage; PULSE(0 5 1m 10u 10u 50m 500m)
Named nets: 0, Vcc/2, Vcc, VIN, EQOUT, Vsig, VOUT
.tran 0 2000m 0 10u
.include pot.sub
.param G=0.5 P0=0.5 P1=0.9 P2=0.5 P3=0.9 P4=0.5 P5=0.5 P6=0.5 P7=0.5
.ac dec 100 10 100K
100Hz
200Hz
400Hz
800Hz
1.6kHz
3.2kHz
6.4kHz
To scale Fc by k, scale C1 and C2 by 1/k
Q = C1/C2
 
To ajust Q and keep Fc: C1*b, C2/b
 
https://www.youtube.com/watch?v=i3xWgun-zb0
50Hz
NMOS JFET
D
G
S
.model FOOTSW SW(Ron=1m Roff=10Meg Vt=0.5 Vh=-0.2)
.noise V(VOUT) V3 dec 100 20 20K
Total RMS noise from 20-20k for TL072H
74.906µV with all sliders at 0.5 and G=0.95
67.332µV with all sliders at 0.5 and G=0.5
 
Total RMS noise from 20-20k for OPA1692 for In/Out Buffer
19.591µV with all sliders at 0.5 and G=0.95
15.721µV with all sliders at 0.5 and G=0.5
S
D
G
C0G/NP0 Available =>
