jakeson21/8-Band-EQ/spice/JFET_BJT_Foot_Switch.asc

C1: cap; 0.022µ; V=16 Irms=0 Rser=0.0511 Lser=447p mfg="Würth Elektronik" pn="885012208029 WCAP-CSGP 1206" type="X7R"
C2: cap; 0.022µ; V=16 Irms=0 Rser=0.0511 Lser=447p mfg="Würth Elektronik" pn="885012208029 WCAP-CSGP 1206" type="X7R"
C4: cap; 470p; V=16 Irms=0 Rser=0.34 Lser=421p mfg="Würth Elektronik" pn="885012208021 WCAP-CSGP 1206" type="X7R"
C5: cap; 220p; V=16 Irms=0 Rser=0.5734 Lser=186p mfg="Würth Elektronik" pn="885012205021 WCAP-CSGP 0402" type="X7R"
C6: cap; 471p; V=16 Irms=0 Rser=0.4 Lser=411p
C7: cap; 221p; V=16 Irms=0 Rser=0.5 Lser=180p
C8: cap; 1n; V=16 Irms=0 Rser=0.5734 Lser=186p
D1: diode; 1N914
D2: diode; 1N914
D3: zener; STZ5_6N
D4: LED; LXHL-BW02
J1: njf; 2N3819
J2: njf; 2N3819
Q1: npn; 2N4401
Q2: npn; 2N4401
R1: res; 1Meg
R2: res; 1Meg
R3: res; 3.9K
R4: res; 1Meg
R5: res; 1Meg
R6: res; 4.7K
R7: res; 100K
R8: res; 56K
R9: res; 56K
R10: res; 101K
R11: res; 57K
R12: res; 57K
R13: res; 1Meg
R14: res; {RS}
R15: res; 10K
S1: sw; FOOTSW
U1: TL072
V1: voltage; SINE(4.5 1 30); AC 1
V2: voltage; SINE(4.5 1 120); AC 1
V3: voltage; 4.5
V4: voltage; 4.5
VSW1: voltage; PULSE(0 0.7 200.03m 70u 1u 1u 400m)
VSW: voltage; PULSE(0 5 0 2u 2u 200m 400m)
Named nets: Vcc/2, Vsig, Vcc, EQOUT, 0
.model FOOTSW SW(Ron=1m Roff=100Meg Vt=0.5 Vh=-0.2)
.tran 0 2 0 5u
.ac dec 100 10 100K
Bistable Multivibrator
D
G
S
S
D
G
.param CS=1n RS=100
.step param RS list 100 1000 10000
