jakeson21/8-Band-EQ/2-Band-EQ-Board/2-Band-EQ-Board.kicad_pcb

## KiCad design 2-Band-EQ-Board/2-Band-EQ-Board.kicad_pcb (2025-08-23)

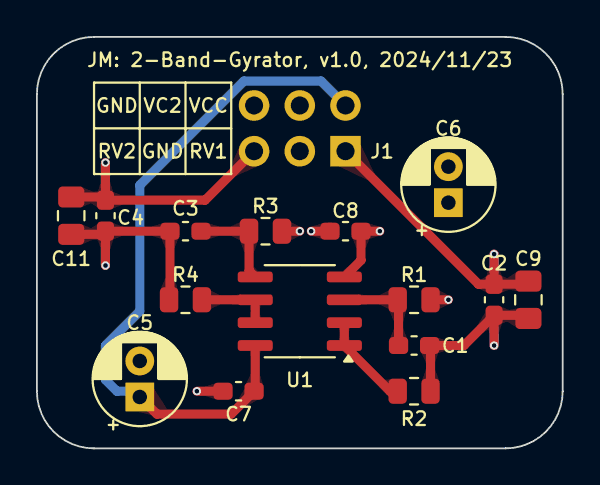
[picture p24: board 2-Band-EQ-Board.kicad_pcb from above]

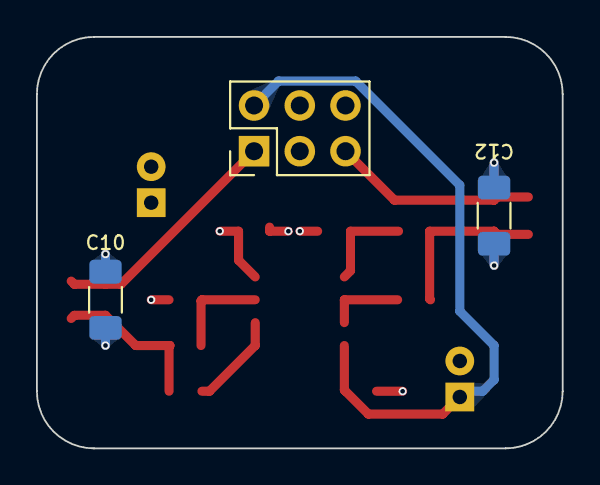
[picture p25: board 2-Band-EQ-Board.kicad_pcb from below]

Board: 4 copper layers, 29.2 x 22.9 mm, 18 parts (3 on the bottom side), 11 nets.

Parts:
C1: 33n; C_0603_1608Metric_Pad1.08x0.95mm_HandSolder
C2: 0.68u; C_0603_1608Metric_Pad1.08x0.95mm_HandSolder
C3: 15n; C_0603_1608Metric_Pad1.08x0.95mm_HandSolder
C4: 0.33u; C_0603_1608Metric_Pad1.08x0.95mm_HandSolder
C5, C6: 100u; CP_Radial_D5.0mm_P2.00mm
C7, C8: 0.1u; C_0603_1608Metric_Pad1.08x0.95mm_HandSolder
C9, C11: 1.5u; C_0805_2012Metric_Pad1.18x1.45mm_HandSolder
C10, C12: 3.3u; C_1206_3216Metric_Pad1.33x1.80mm_HandSolder
J1: PHED-DS006G1ABOGA-A006; PinHeader_2x03_P2.54mm_Vertical
R1, R3: 100K; R_0805_2012Metric
R2, R4: 330; R_0805_2012Metric
U1: 296-TL072HIDRCT-ND; SOIC-8_3.9x4.9mm_P1.27mm

Connections:
/RV1: C2.2, C9.2, C10.2, J1.1
/RV2: C4.2, C11.2, C12.2, J1.5
/VCC/2: C5.2, C6.1, C7.1, C8.2, J1.4, R1.1, R3.1
GNDA: C6.2, C8.1, J1.3, J1.6, U1.4 (V-)
unnamed: C1.2, C2.1, C9.1, C10.1, R2.1
unnamed: C3.2, C4.1, C11.1, C12.1, R4.1
unnamed: C1.1, R1.2, U1.3 (+)
unnamed: R2.2, U1.1, U1.2 (-)
unnamed: C3.1, R3.2, U1.5 (+)
unnamed: R4.2, U1.6 (-), U1.7
VCC: C5.1, C7.2, J1.2, U1.8 (V+)
