jakeson21/8-Band-EQ/Input_Output_Switch/Input_Output_Switch.kicad_pcb

## KiCad design Input_Output_Switch/Input_Output_Switch.kicad_pcb (2025-08-23)

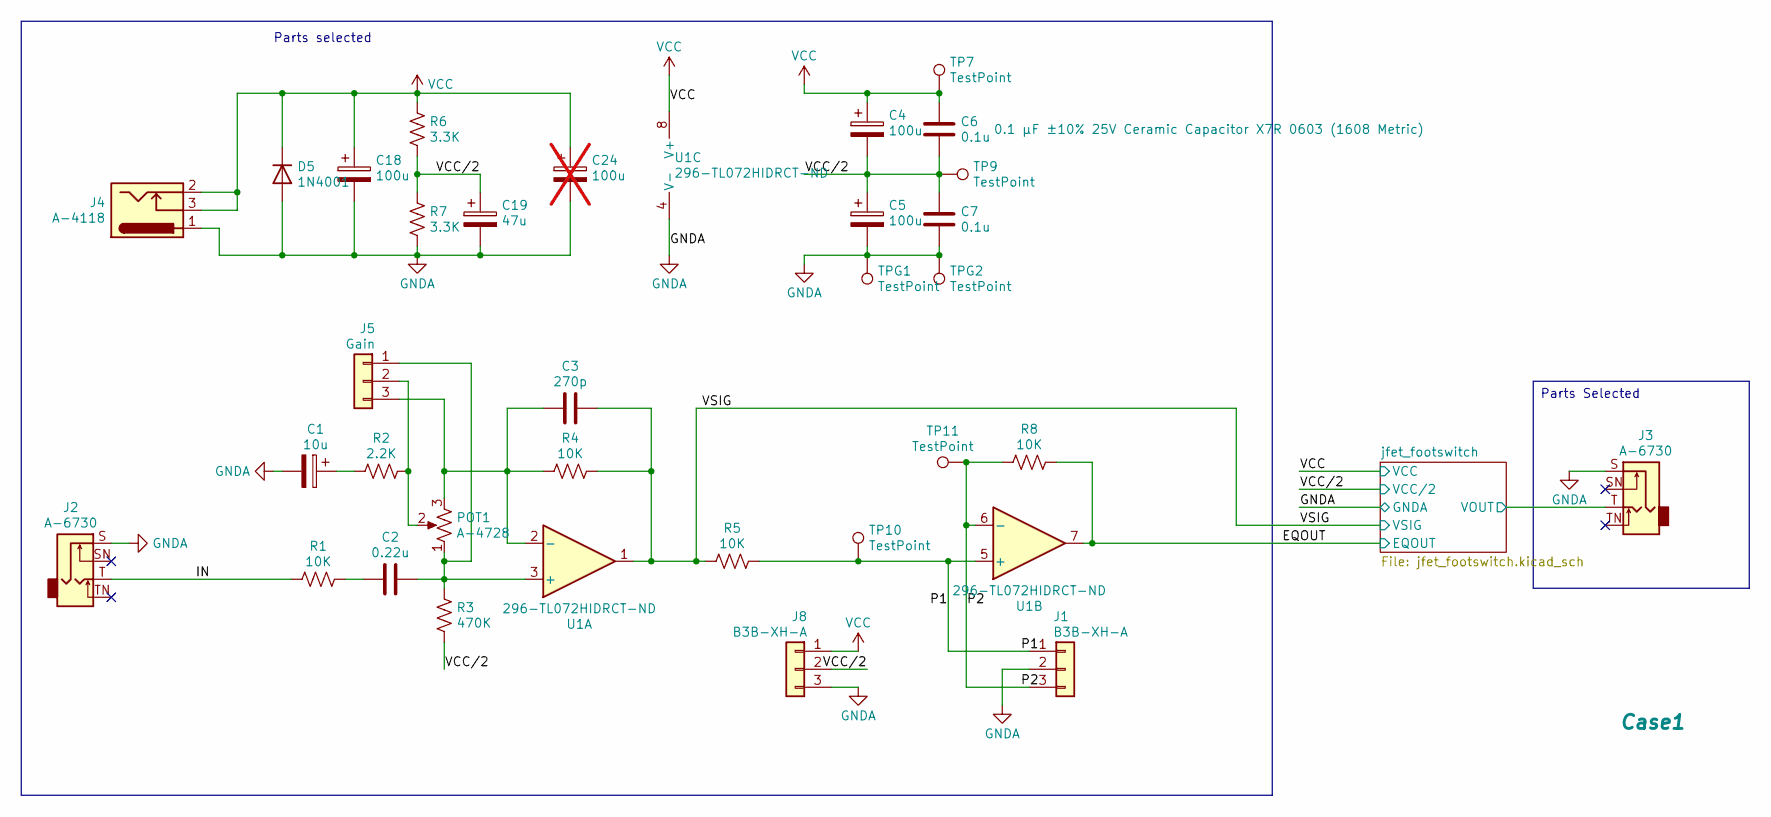
[picture p26: schematic Input_Output_Switch.kicad_sch, EQ8-Main-Board]

Parts:
C1: 10u; CP_Elec_4x5.4
C2: 0.22u; C_0603_1608Metric_Pad1.08x0.95mm_HandSolder
C3: 270p; C_0603_1608Metric_Pad1.08x0.95mm_HandSolder
C4, C5, C18: 100u; CP_Radial_D5.0mm_P2.00mm
C6, C7: 0.1u; C_0603_1608Metric_Pad1.08x0.95mm_HandSolder
C19: 47u; CP_Radial_D5.0mm_P2.00mm
C24: 100u; CP_EIA-7343-31_Kemet-D_Pad2.25x2.55mm_HandSolder; not fitted
Case1: Hammond_1444-542
D5: 1N4001; D_DO-41_SOD81_P7.62mm_Horizontal
J1, J8: B3B-XH-A; JST_XH_B3B-XH-A_1x03_P2.50mm_Vertical
J2, J3: A-6730; Jack_6.35mm_Neutrik_NMJ4HFD2_Horizontal
J4: A-4118; BarrelJack_Horizontal
J5: Gain; PinHeader_1x03_P2.54mm_Vertical
POT1: A-4728; Potentiometer_Alpha_RD901F-40-00D_Single_Vertical_CircularH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
R1, R4, R5, R8: 10K; R_0805_2012Metric
R2: 2.2K; R_0805_2012Metric
R3: 470K; R_0805_2012Metric
R6, R7: 3.3K; R_0805_2012Metric
TP7, TP9, TP10, TP11: TestPoint; TestPoint_Pad_1.0x1.0mm
TPG1, TPG2: TestPoint; TestPoint_Pad_1.0x1.0mm
U1: 296-TL072HIDRCT-ND; SOIC-8_3.9x4.9mm_P1.27mm

Connections:
/EQOUT: R8.2, U1.7; also elsewhere on the board
/IN: J2.T, R1.1
/P1: J1.1, R5.2, TP10.1, U1.5 (+)
/P2: J1.3, R8.1, TP11.1, U1.6 (-)
/VSIG: C3.2, R4.2, R5.1, U1.1; also elsewhere on the board
/jfet_footswitch/VOUT: J3.T; also elsewhere on the board
GNDA: C1.2, C5.2, C7.1, C18.2, C19.2, C24.2, D5.2 (A), J1.2, J2.S, J3.S, J4.1, J8.3, R7.2, TPG1.1, TPG2.1, U1.4 (V-); also elsewhere on the board
unnamed: C1.1, R2.2
unnamed: C2.1, R1.2
unnamed: C2.2, J5.1, POT1.1, R3.2, U1.3 (+)
unnamed: J5.2, POT1.2, R2.1
unnamed: C3.1, J5.3, POT1.3, R4.1, U1.2 (-)
VCC: C4.1, C6.2, C18.1, C24.1, D5.1 (K), J4.2, J4.3, J8.1, R6.1, TP7.1, U1.8 (V+); also elsewhere on the board
VCC/2: C4.2, C5.1, C6.1, C7.2, C19.1, J8.2, R3.1, R6.2, R7.1, TP9.1; also elsewhere on the board

Notes on the sheet:
Parts selected
Parts Selected

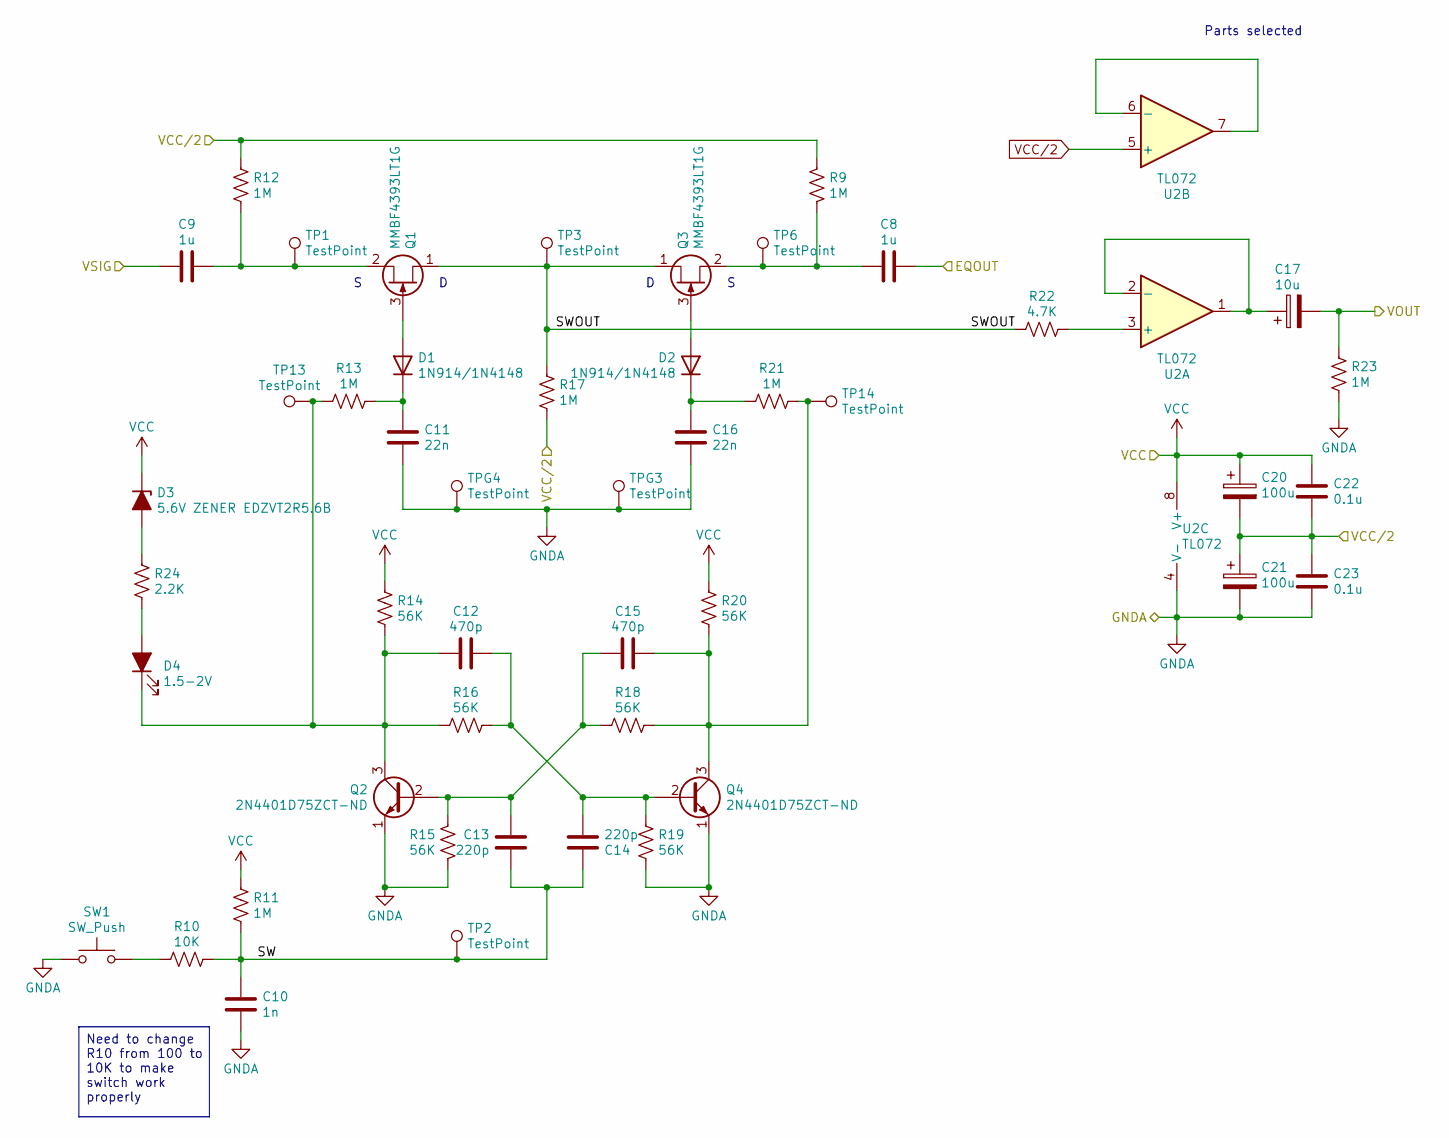
[picture p27: schematic jfet_footswitch.kicad_sch, EQ8-Main-Board]

Parts:
C8, C9: 1u; C_0603_1608Metric_Pad1.08x0.95mm_HandSolder
C10: 1n; C_0603_1608Metric_Pad1.08x0.95mm_HandSolder
C11, C16: 22n; C_0603_1608Metric_Pad1.08x0.95mm_HandSolder
C12, C15: 470p; C_0603_1608Metric_Pad1.08x0.95mm_HandSolder
C13, C14: 220p; C_0603_1608Metric_Pad1.08x0.95mm_HandSolder
C17: 10u; CP_Elec_4x5.4
C20, C21: 100u; CP_Radial_D5.0mm_P2.00mm
C22, C23: 0.1u; C_0603_1608Metric_Pad1.08x0.95mm_HandSolder
D1, D2: 1N914/1N4148; D_DO-35_SOD27_P2.54mm_Vertical_AnodeUp
D3: 5.6V ZENER EDZVT2R5.6B; D_SOD-523
D4: 1.5-2V; LED_D3.0mm_Clear
Q1, Q3: MMBF4393LT1G; SOT-23-3
Q2, Q4: 2N4401D75ZCT-ND; TO-92_Inline_Wide
R9, R11, R12, R13, R17, R21, R23: 1M; R_0805_2012Metric
R10: 10K; R_0805_2012Metric
R14, R15, R16, R18, R19, R20: 56K; R_0805_2012Metric
R22: 4.7K; R_0805_2012Metric
R24: 2.2K; R_0805_2012Metric
SW1: SW_Push; Molex_KK-254_AE-6410-02A_1x02_P2.54mm_Vertical
TP1, TP2, TP3, TP6, TP13, TP14: TestPoint; TestPoint_Pad_1.0x1.0mm
TPG3, TPG4: TestPoint; TestPoint_Pad_1.0x1.0mm
U2: TL072; SOIC-8_3.9x4.9mm_P1.27mm

Connections:
/EQOUT: C8.2; also elsewhere on the board
/VSIG: C9.1; also elsewhere on the board
/jfet_footswitch/SW: C10.2, C13.1, C14.2, R10.2, R11.1, TP2.1
/jfet_footswitch/SWOUT: Q1.1 (D), Q3.1 (D), R17.2, R22.2, TP3.1
/jfet_footswitch/VOUT: C17.2, R23.2; also elsewhere on the board
GNDA: C10.1, C11.1, C16.1, C21.2, C23.1, Q2.1 (E), Q4.1 (E), R15.1, R19.1, R23.1, SW1.1, TPG3.1, TPG4.1, U2.4 (V-); also elsewhere on the board
unnamed: D1.2 (A), Q1.3 (G)
unnamed: C11.2, D1.1 (K), R13.2
unnamed: D2.2 (A), Q3.3 (G)
unnamed: C16.2, D2.1 (K), R21.2
unnamed: D3.2 (A), R24.2
unnamed: D4.2 (A), R24.1
unnamed: C12.1, D4.1 (K), Q2.3 (C), R13.1, R14.1, R16.2, TP13.1
unnamed: C9.2, Q1.2 (S), R12.2, TP1.1
unnamed: C13.2, C15.2, Q2.2 (B), R15.2, R18.2
unnamed: C8.1, Q3.2 (S), R9.2, TP6.1
unnamed: C12.2, C14.1, Q4.2 (B), R16.1, R19.2
unnamed: C15.1, Q4.3 (C), R18.1, R20.1, R21.1, TP14.1
unnamed: R10.1, SW1.2
unnamed: R22.1, U2.3 (+)
unnamed: C17.1, U2.1, U2.2 (-)
unnamed: U2.6 (-), U2.7
VCC: C20.1, C22.2, D3.1 (K), R11.2, R14.2, R20.2, U2.8 (V+); also elsewhere on the board
VCC/2: C20.2, C21.1, C22.1, C23.2, R9.1, R12.1, R17.1, U2.5 (+); also elsewhere on the board

Notes on the sheet:
Parts selected
Need to change R10 from 100 to 10K to make switch work properly

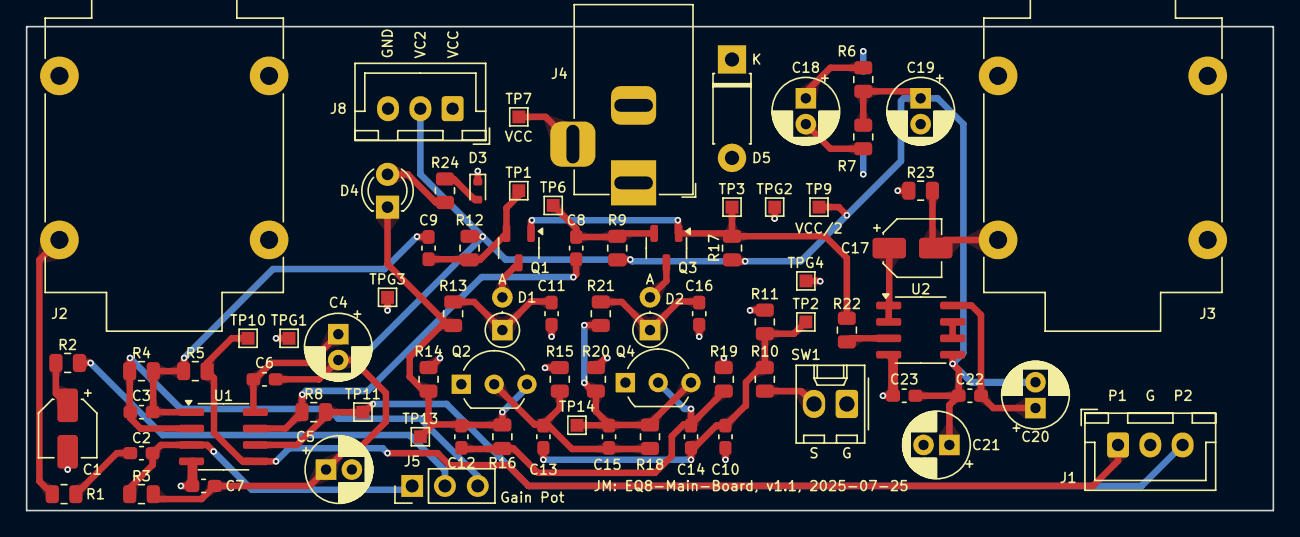
[picture p28: board Input_Output_Switch.kicad_pcb from above]

Board: 4 copper layers, 96.5 x 37.5 mm, 81 parts (1 on the bottom side), 32 nets.
