jakeson21/8-Band-EQ/Row-of-4-pots/Row-of-4-pots.kicad_pcb

## KiCad design Row-of-4-pots/Row-of-4-pots.kicad_pcb (2025-08-23)

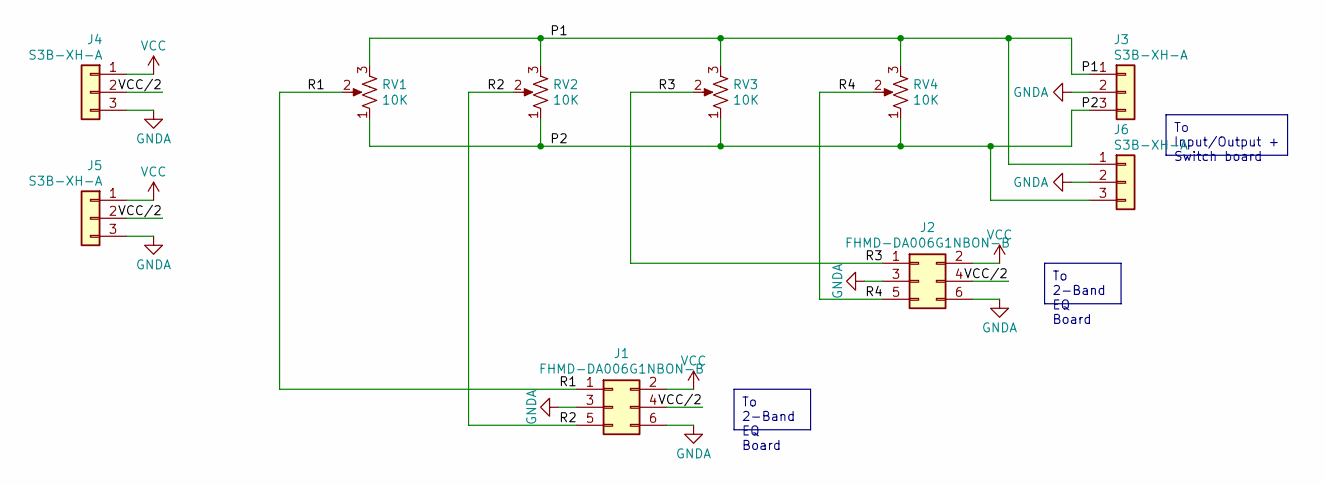
[picture p29: schematic Row-of-4-pots.kicad_sch]

Parts:
J1, J2: FHMD-DA006G1NBON-B; PinSocket_2x03_P2.54mm_Vertical
J3, J4, J5, J6: S3B-XH-A; JST_XH_S3B-XH-A_1x03_P2.50mm_Horizontal
RV1, RV2, RV3, RV4: 10K; Potentiometer_Alpha_RD901F-40-00D_Single_Vertical_CircularH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

Connections:
/P1: J3.1, J6.1, RV1.3, RV2.3, RV3.3, RV4.3
/P2: J3.3, J6.3, RV1.1, RV2.1, RV3.1, RV4.1
/R1: J1.1, RV1.2
/R2: J1.5, RV2.2
/R3: J2.1, RV3.2
/R4: J2.5, RV4.2
/VCC/2: J1.4, J2.4, J4.2, J5.2
GNDA: J1.3, J1.6, J2.3, J2.6, J3.2, J4.3, J5.3, J6.2
VCC: J1.2, J2.2, J4.1, J5.1

Notes on the sheet:
To 2-Band EQ Board
To Input/Output + Switch board

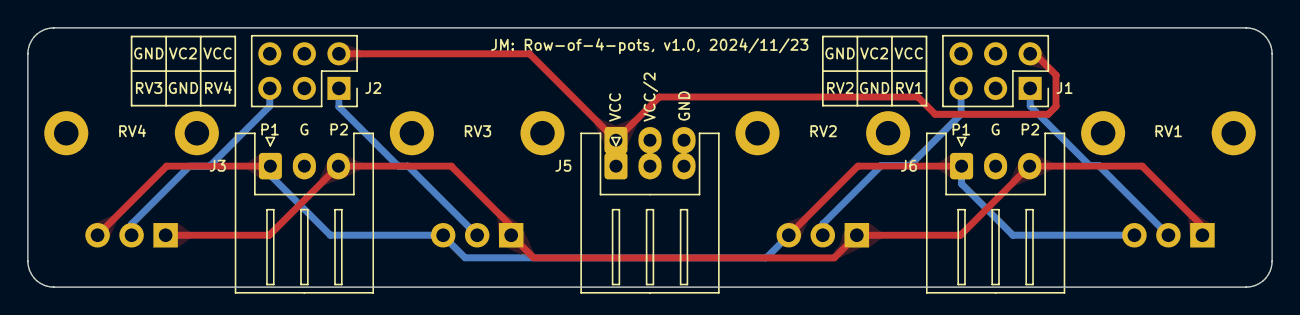
[picture p30: board Row-of-4-pots.kicad_pcb from above]

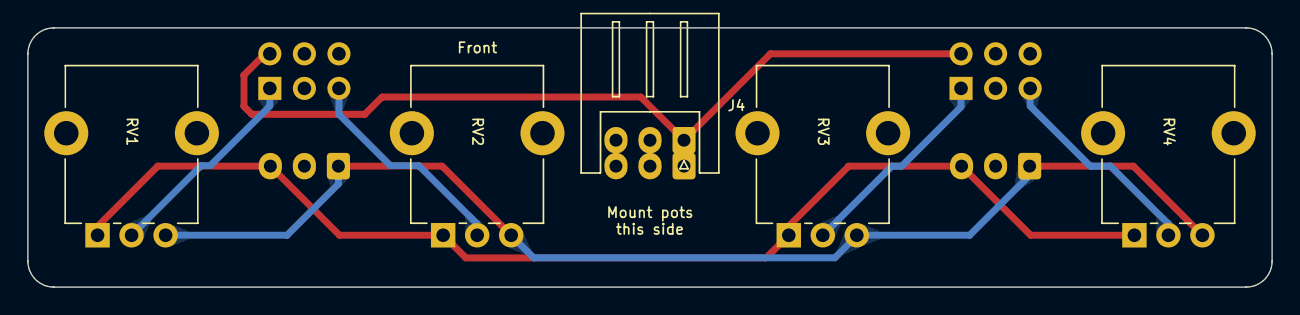
[picture p31: board Row-of-4-pots.kicad_pcb from below]

Board: 4 copper layers, 91.4 x 19.0 mm, 10 parts (5 on the bottom side), 9 nets.
