jakeson21/8-Band-EQ/(commit log)

2024-11-23 Master merge into main (#1)
    * Initial commit
    * current state of design
    [1444-542.igs, 1444-542.stp, 2-Band-EQ-Board.kicad_pcb, 2-Band-EQ-Board.kicad_sch, A 3216-18.iges, A 3216-18.step, B 3528-21.iges, B 3528-21.step]
2024-11-24 Final version 1.0 ordered
    [2-Band-EQ-Board.kicad_pcb, 2-Band-EQ-Board.kicad_sch, Combined-BOM.xlsx, Input_Output_Switch.kicad_pcb, Input_Output_Switch.kicad_sch, Row-of-4-pots.kicad_pcb, Row-of-4-pots.kicad_sch, jfet_footswitch.kicad_sch]
2025-08-23 Fix bypass resistor, add missing Vcc. Move to Kicad-9
